Brain-dll/MIDDLE-ALTITUDE-GROUND-STATION-EMBEDDED-/HARDWARE/REV4.0/Mergen Ground Station_V2.0.brd

## EAGLE design HARDWARE/REV4.0/Mergen Ground Station_V2.0.brd (2021-09-17)

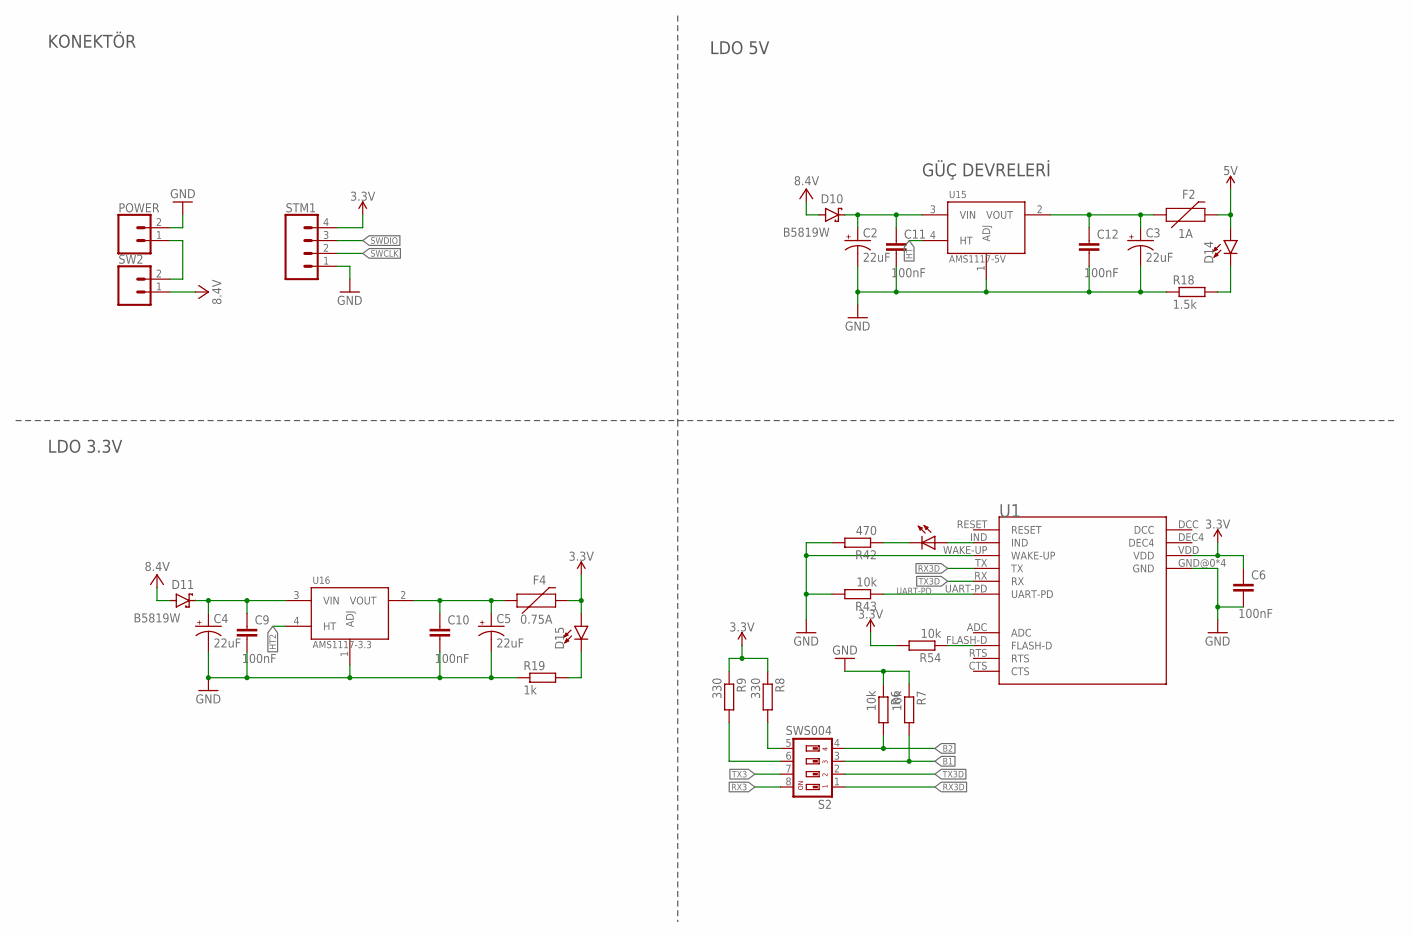
[picture p1: schematic Mergen Ground Station_V2.0.sch, sheet 1]

Parts:
C2, C3, C4, C5: 22uF; CT3528
C6, C9, C10, C11, C12: 100nF; C0603
D10, D11: B5819W; SODFL3718X115
D14, D15: LED0603; LED-0603
DRM3: kirmizi; CHIP-LED0805
F2: 1A; 1206
F4: 0.75A; 1206
POWER: CONN_023.5MM-NO_SILK; SCREWTERMINAL-3.5MM-2-NS
R6, R7, R43, R54: 10k; R0603
R8, R9: 330; R0603
R18: 1.5k; R0603
R19: 1k; R0603
R42: 470; R0603
S2: SWS004; SMS-004
STM1: CONN_04; 1X04
SW2: CONN_023.5MM-NO_SILK; SCREWTERMINAL-3.5MM-2-NS
U1: MDBT42T-AT
U15: AMS1117-5V; SOT229P700X180-4N
U16: AMS1117-3.3; SOT229P700X180-4N

Connections:
3.3V: C6.1, D15.A, F4.2, R8.1, R9.1, R54.2, STM1.4, U1.VDD; also elsewhere on the board
5V: D14.A, F2.2; also elsewhere on the board
B1: R7.2, S2.3; also elsewhere on the board
B2: R6.2, S2.4; also elsewhere on the board
FLASH-D: R54.1, U1.FLASH-D; also elsewhere on the board
GND: C2.-, C3.-, C4.-, C5.-, C6.2, C9.2, C10.2, C11.2, C12.2, POWER.2, R6.1, R7.1, R18.1, R19.1, R42.2, R43.2, STM1.1, U1.GND@0 (GND), U1.GND@1 (GND), U1.GND@2 (GND), U1.GND@3 (GND), U1.WAKE-UP, U15.1 (ADJ), U16.1 (ADJ); also elsewhere on the board
HT: U15.4 (HT)
HT2: U16.4 (HT)
unnamed: DRM3.A, U1.IND
unnamed: DRM3.C, R42.1
unnamed: R9.2, S2.6
unnamed: R8.2, S2.5
unnamed: C2.+, C11.1, D10.1 (C), U15.3 (VIN)
unnamed: C3.+, C12.1, F2.1, U15.2 (VOUT)
unnamed: C4.+, C9.1, D11.1 (C), U16.3 (VIN)
unnamed: C5.+, C10.1, F4.1, U16.2 (VOUT)
unnamed: POWER.1, SW2.2
unnamed: D14.C, R18.2
unnamed: D15.C, R19.2
RX3: S2.8; also elsewhere on the board
RX3D: S2.1, U1.TX
SWCLK: STM1.2; also elsewhere on the board
SWDIO: STM1.3; also elsewhere on the board
TX3: S2.7; also elsewhere on the board
TX3D: S2.2, U1.RX
UART-PD: R43.1, U1.UART-PD; also elsewhere on the board
VCC: D10.2 (A), D11.2 (A), SW2.1; also elsewhere on the board

Notes on the sheet:
GÜÇ DEVRELERİ
KONEKTÖR
LDO 5V
LDO 3.3V

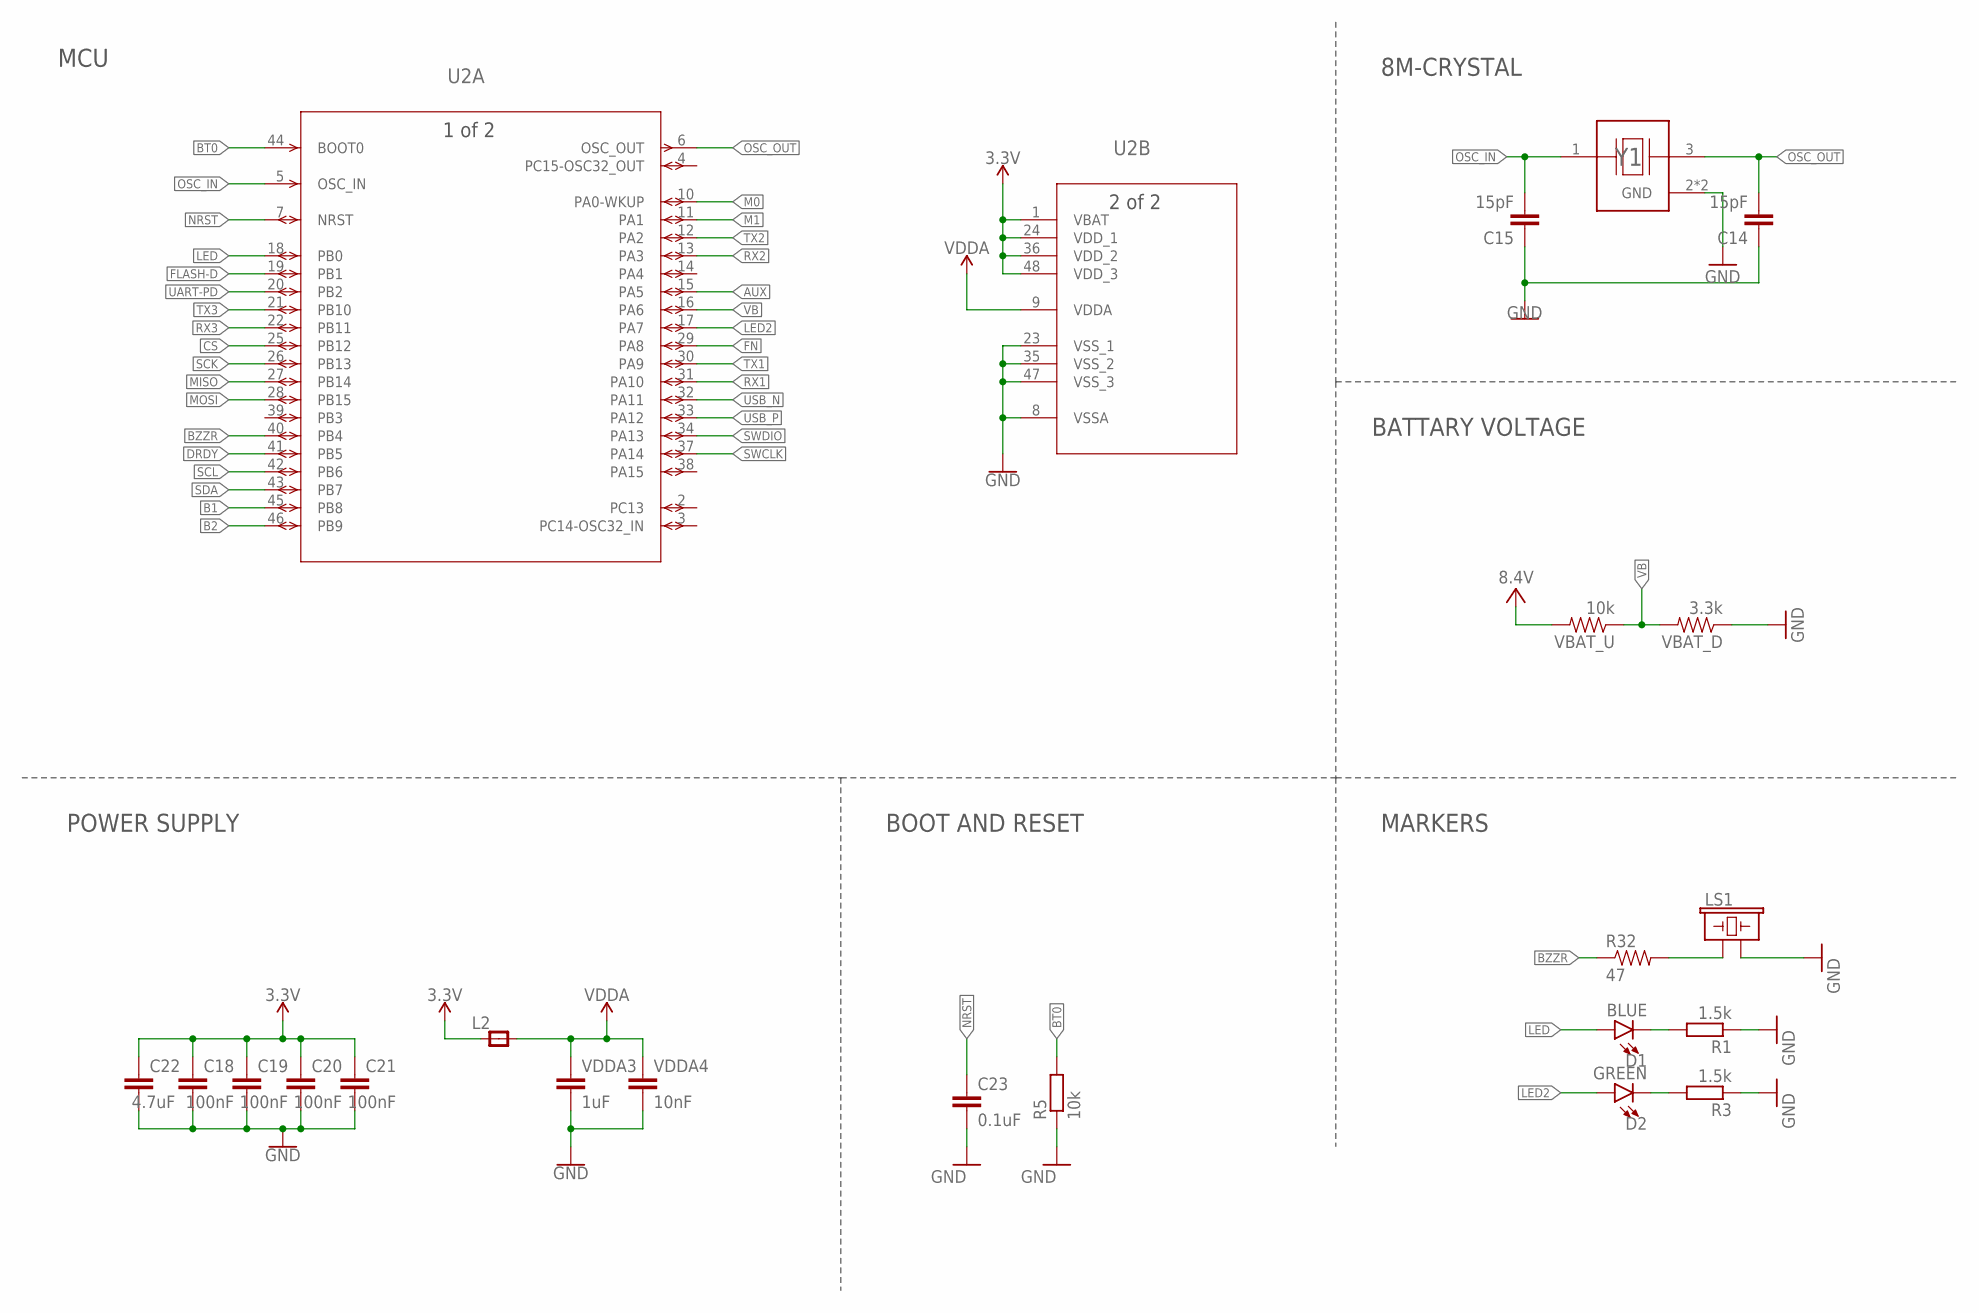
[picture p2: schematic Mergen Ground Station_V2.0.sch, sheet 2]

Parts:
C14, C15: 15pF; C0603
C18, C19, C20, C21: 100nF; C0603
C22: 4.7uF; C0603
C23: 0.1uF; C0603
D1: BLUE; LED-0603
D2: GREEN; LED-0603
L2: RC-MASTER-SMD_FB_0805MP; RC-MASTER-SMD_L0805MP
LS1: BUZZER-PTH; BUZZER-12MM
R1, R3: 1.5k; R0603
R5: 10k; R0603
R32: 47; 0603
U2: STM32F103C8T6; LQFP48-7X7MM
VBAT_D: 3.3k; 0603-RES
VBAT_U: 10k; 0603-RES
VDDA3: 1uF; 0603
VDDA4: 10nF; 0603
Y1: ABMM2-8.000MHZ-E2-T; XTAL_ABMM2-8.000MHZ-E2-T

Connections:
3.3V: C18.1, C19.1, C20.1, C21.1, C22.1, L2.1, U2.1 (VBAT), U2.24 (VDD_1), U2.36 (VDD_2), U2.48 (VDD_3); also elsewhere on the board
AUX: U2.15 (PA5); also elsewhere on the board
B1: U2.45 (PB8); also elsewhere on the board
B2: U2.46 (PB9); also elsewhere on the board
BT0: R5.2, U2.44 (BOOT0)
BZZR: R32.1, U2.40 (PB4)
CS: U2.25 (PB12); also elsewhere on the board
DRDY: U2.41 (PB5); also elsewhere on the board
FLASH-D: U2.19 (PB1); also elsewhere on the board
FN: U2.29 (PA8); also elsewhere on the board
GND: C14.1, C15.1, C18.2, C19.2, C20.2, C21.2, C22.2, C23.2, LS1.- (2), R1.1, R3.1, R5.1, U2.8 (VSSA), U2.23 (VSS_1), U2.35 (VSS_2), U2.47 (VSS_3), VBAT_D.1, VDDA3.2, VDDA4.2, Y1.2 (GND), Y1.4 (GND); also elsewhere on the board
LED: D1.A, U2.18 (PB0)
LED2: D2.A, U2.17 (PA7)
M0: U2.10 (PA0-WKUP); also elsewhere on the board
M1: U2.11 (PA1); also elsewhere on the board
MISO: U2.27 (PB14); also elsewhere on the board
MOSI: U2.28 (PB15); also elsewhere on the board
unnamed: D1.C, R1.2
unnamed: D2.C, R3.2
unnamed: LS1.+ (1), R32.2
NRST: C23.1, U2.7 (NRST)
OSC_IN: C15.2, U2.5 (OSC_IN), Y1.1
OSC_OUT: C14.2, U2.6 (OSC_OUT), Y1.3
RX1: U2.31 (PA10); also elsewhere on the board
RX2: U2.13 (PA3); also elsewhere on the board
RX3: U2.22 (PB11); also elsewhere on the board
SCK: U2.26 (PB13); also elsewhere on the board
SCL: U2.42 (PB6); also elsewhere on the board
SDA: U2.43 (PB7); also elsewhere on the board
SWCLK: U2.37 (PA14); also elsewhere on the board
SWDIO: U2.34 (PA13); also elsewhere on the board
TX1: U2.30 (PA9); also elsewhere on the board
TX2: U2.12 (PA2); also elsewhere on the board
TX3: U2.21 (PB10); also elsewhere on the board
UART-PD: U2.20 (PB2); also elsewhere on the board
USB_N: U2.32 (PA11); also elsewhere on the board
USB_P: U2.33 (PA12); also elsewhere on the board
VB: U2.16 (PA6), VBAT_D.2, VBAT_U.1
VCC: VBAT_U.2; also elsewhere on the board
VDDA: L2.2, U2.9 (VDDA), VDDA3.1, VDDA4.1

Notes on the sheet:
MCU
8M-CRYSTAL
BATTARY VOLTAGE
MARKERS
BOOT AND RESET
POWER SUPPLY

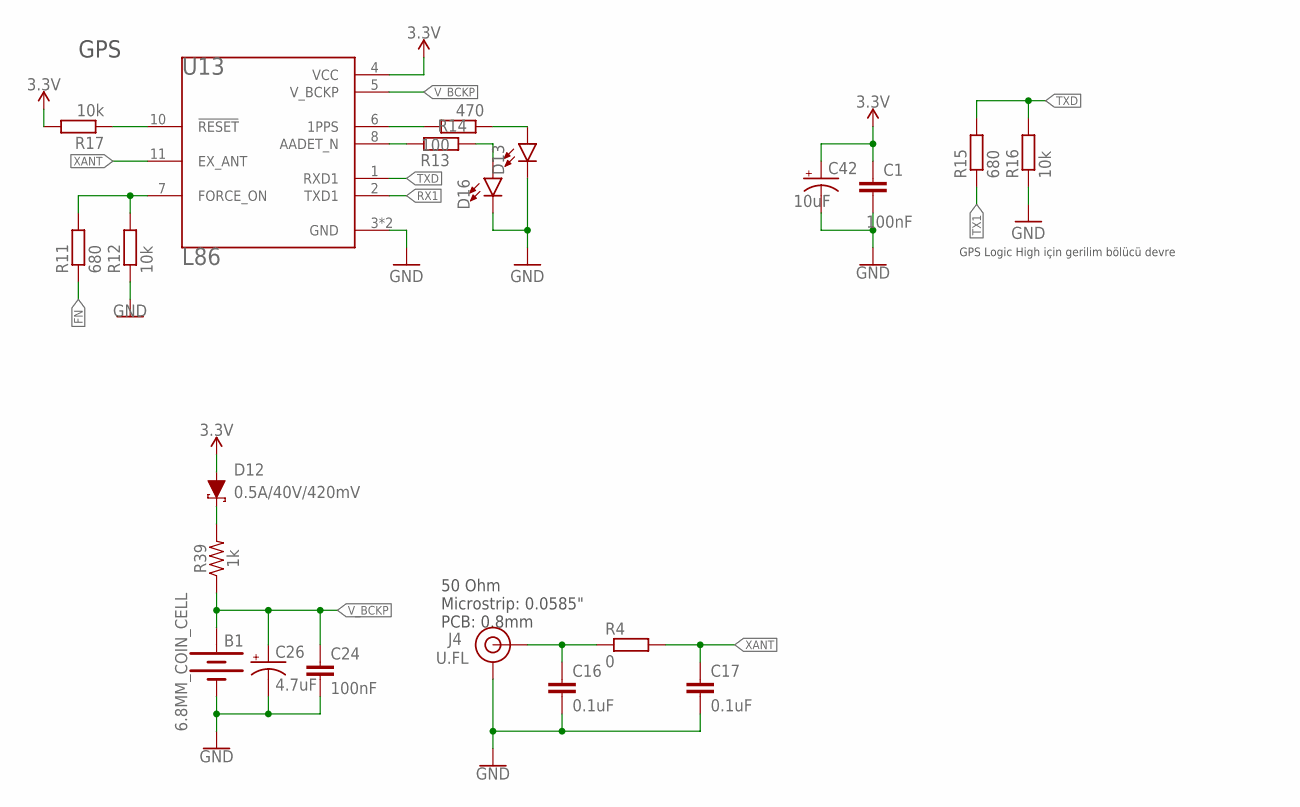
[picture p3: schematic Mergen Ground Station_V2.0.sch, sheet 3]

Parts:
B1: 6.8MM_COIN_CELL; BATTCON-6.8MM
C1, C24: 100nF; C0603
C16, C17: 0.1uF; C0603
C26: 4.7uF; A/3216-18R
C42: 10uF; EIA3216
D12: 0.5A/40V/420mV; SOD-323
D13, D16: LED0603; LED-0603
J4: U.FL
R4: 0; R0603
R11, R15: 680; R0603
R12, R16, R17: 10k; R0603
R13: 100; R0603
R14: 470; R0603
R39: 1k; 0603
U13: L86; XCVR_L86

Connections:
3.3V: C1.1, C42.+, D12.A, R17.2, U13.4 (VCC); also elsewhere on the board
FN: R11.1; also elsewhere on the board
GND: B1.-, C1.2, C16.2, C17.2, C24.2, C26.-, C42.-, D13.C, D16.C, J4.1 (GND), J4.2 (GND), R12.1, R16.1, U13.3 (GND), U13.12 (GND); also elsewhere on the board
unnamed: D16.A, R13.1
unnamed: D12.C, R39.2
unnamed: R17.1, U13.10 (!RESET)
unnamed: R14.2, U13.6 (1PPS)
unnamed: D13.A, R14.1
unnamed: R13.2, U13.8 (AADET_N)
unnamed: C16.1, J4.FEED (SIGNAL), R4.1
unnamed: R11.2, R12.2, U13.7 (FORCE_ON)
RX1: U13.2 (TXD1); also elsewhere on the board
TX1: R15.1; also elsewhere on the board
TXD: R15.2, R16.2, U13.1 (RXD1)
V_BCKP: B1.+, C24.1, C26.+, R39.1, U13.5 (V_BCKP)
XANT: C17.1, R4.2, U13.11 (EX_ANT)

Notes on the sheet:
GPS
GPS Logic High için gerilim bölücü devre
50 Ohm Microstrip: 0.0585" PCB: 0.8mm

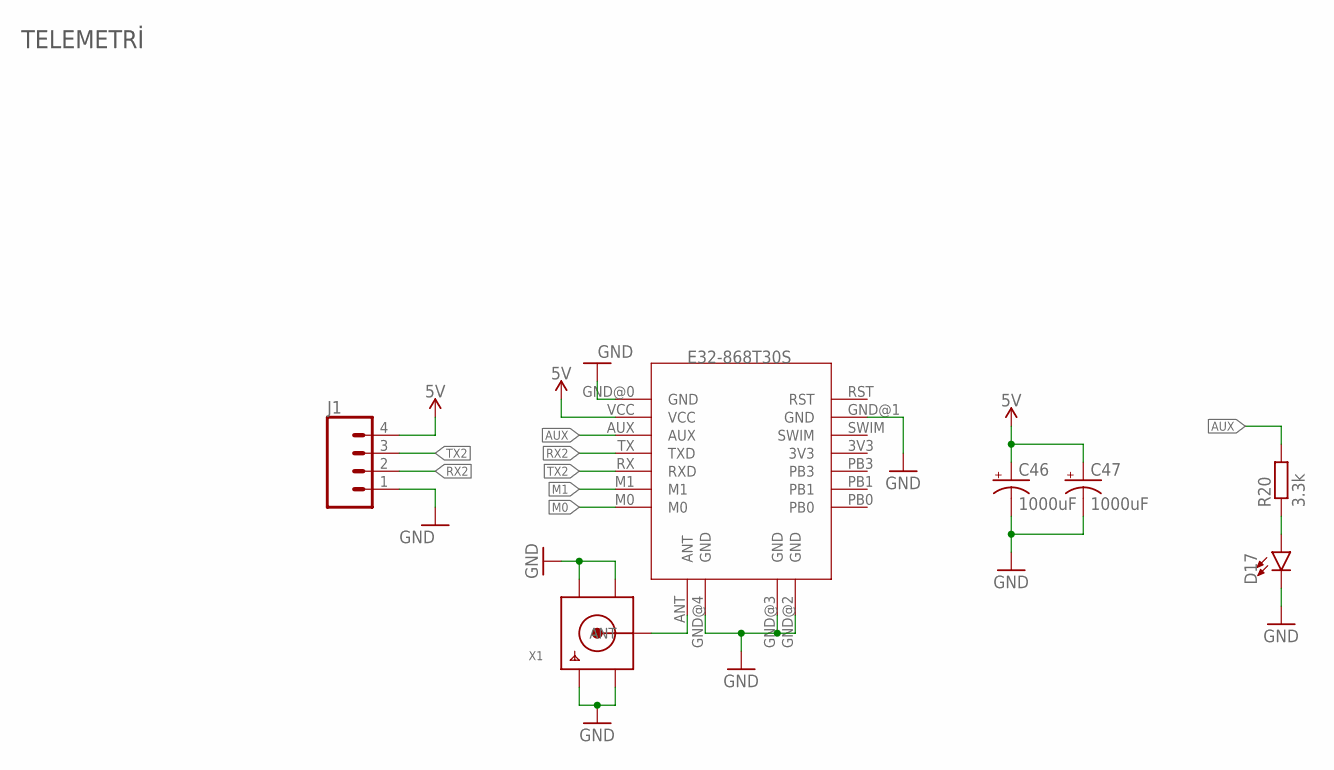
[picture p4: schematic Mergen Ground Station_V2.0.sch, sheet 4]

Parts:
C46, C47: 1000uF; 150CLZ-1010
D17: LED0603; LED-0603
J1: CONN_04; 1X04
R20: 3.3k; R0603
U14: E32-868T30S
X1: SMACONNECTOR; SMA90_DIP

Connections:
5V: C46.+, C47.+, J1.4, U14.VCC; also elsewhere on the board
AUX: R20.2, U14.AUX; also elsewhere on the board
GND: C46.-, C47.-, D17.C, J1.1, U14.GND@0 (GND), U14.GND@1 (GND), U14.GND@2 (GND), U14.GND@3 (GND), U14.GND@4 (GND), X1.GND1, X1.GND2, X1.GND3, X1.GND4; also elsewhere on the board
M0: U14.M0; also elsewhere on the board
M1: U14.M1; also elsewhere on the board
unnamed: U14.ANT, X1.ANTENNA (ANT)
unnamed: D17.A, R20.1
RX2: J1.2, U14.TX (TXD); also elsewhere on the board
TX2: J1.3, U14.RX (RXD); also elsewhere on the board

Notes on the sheet:
TELEMETRİ

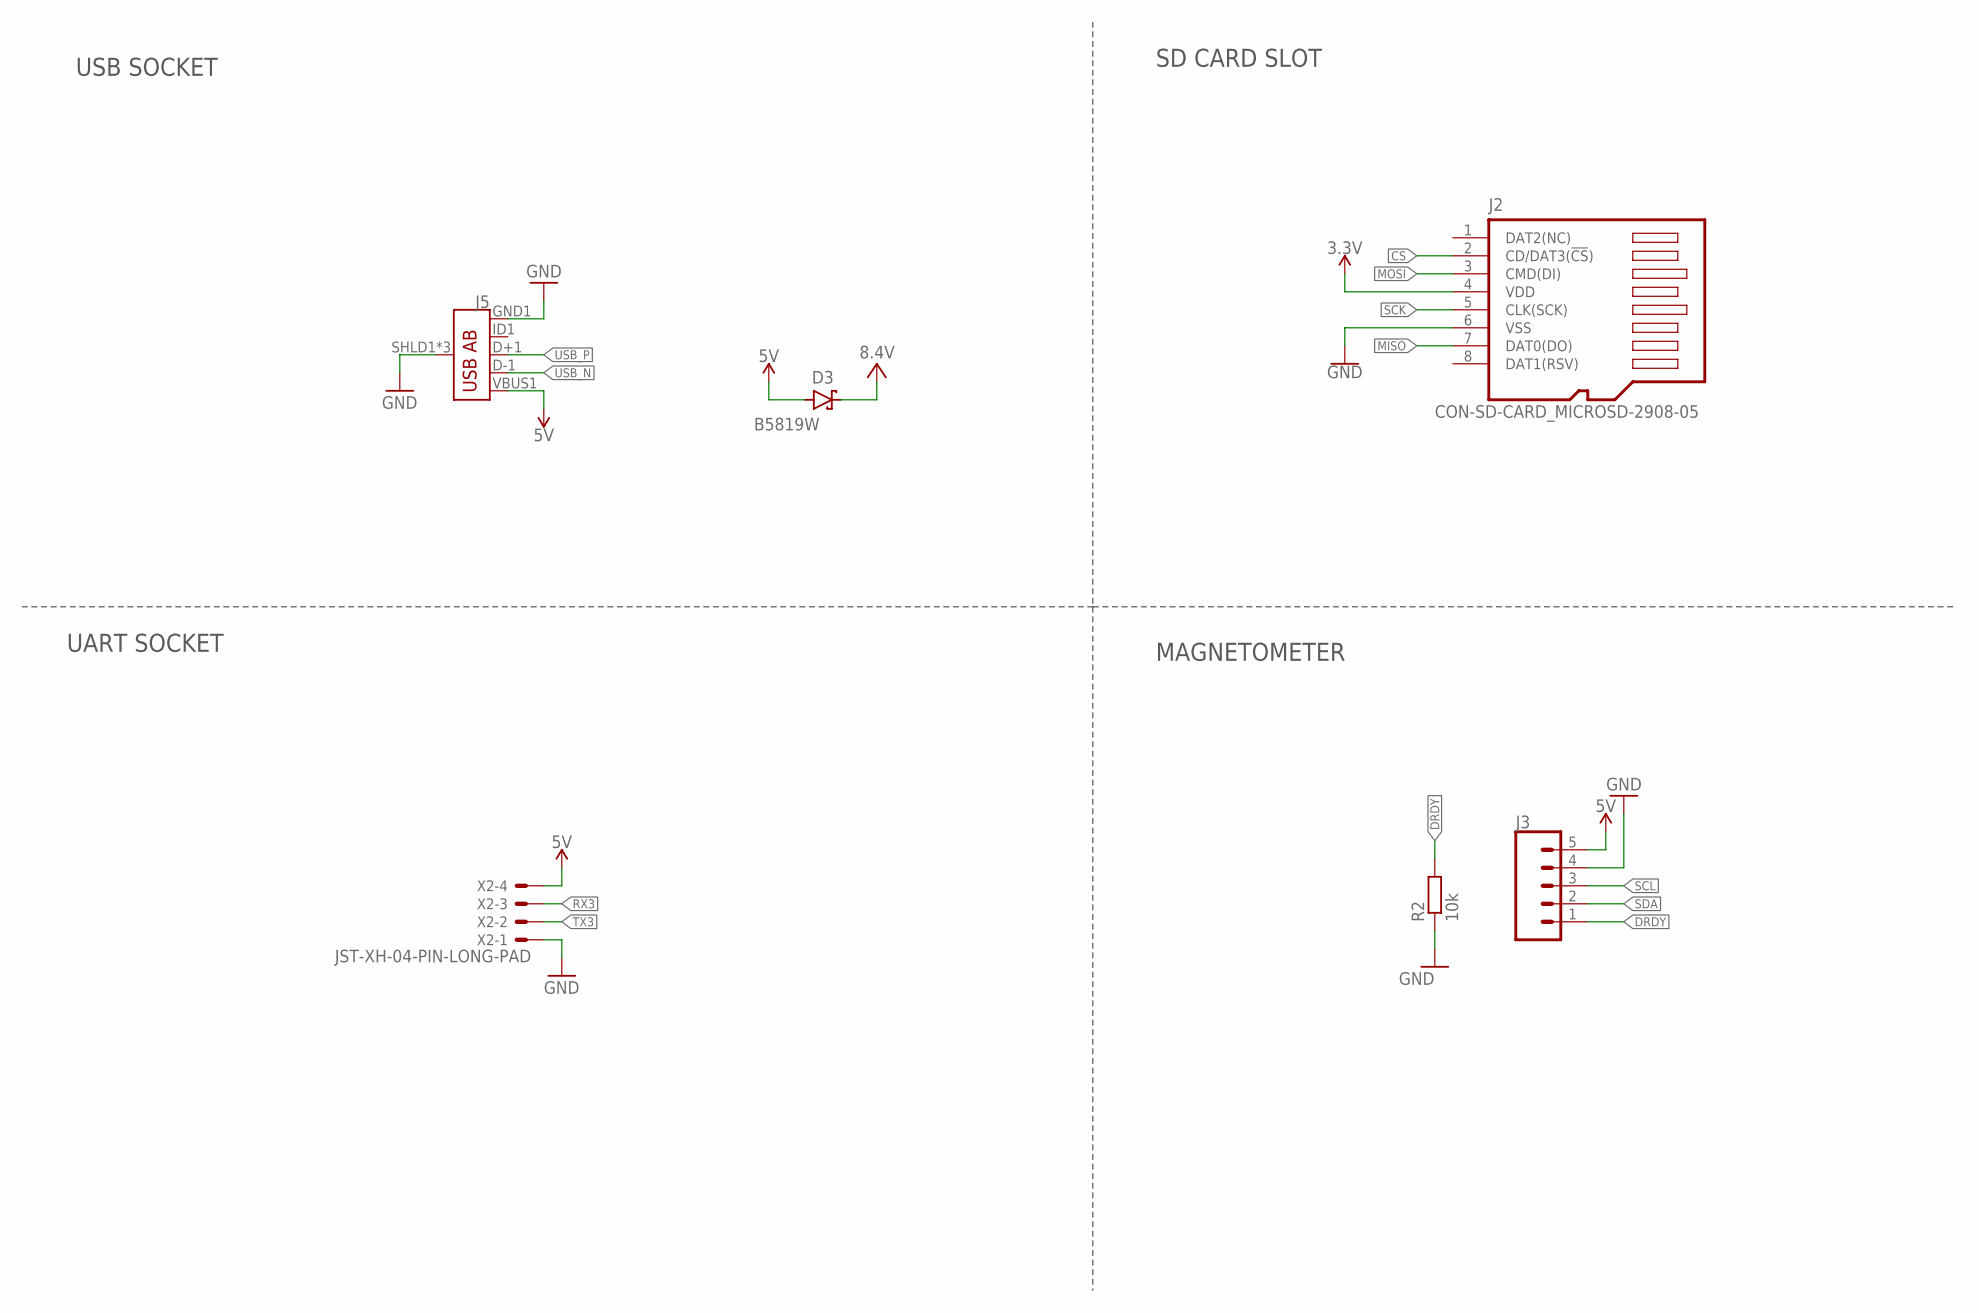
[picture p5: schematic Mergen Ground Station_V2.0.sch, sheet 5]

Parts:
D3: B5819W; SODFL3718X115
J2: CON-SD-CARD_MICROSD-2908-05; CON-SD-CARD_2908-05
J3: CONN_05LOCK_LONGPADS; 1X05_LOCK_LONGPADS
J5: USB_AB_SMT; USB-AB-MICRO-SMD
R2: 10k; R0603
X2: JST-XH-04-PIN-LONG-PAD; JST-XH-04-PACKAGE-LONG-PAD

Connections:
3.3V: J2.4 (VDD); also elsewhere on the board
5V: D3.2 (A), J3.5, J5.VBUS1 (VBUS), X2.4; also elsewhere on the board
CS: J2.2 (CD/DAT3(!CS!)); also elsewhere on the board
DRDY: J3.1, R2.2; also elsewhere on the board
GND: J2.6 (VSS), J3.4, J5.GND1 (GND), J5.SHLD1 (SHIELD), J5.SHLD2 (SHIELD), J5.SHLD3 (SHIELD), R2.1, X2.1; also elsewhere on the board
MISO: J2.7 (DAT0(DO)); also elsewhere on the board
MOSI: J2.3 (CMD(DI)); also elsewhere on the board
RX3: X2.3; also elsewhere on the board
SCK: J2.5 (CLK(SCK)); also elsewhere on the board
SCL: J3.3; also elsewhere on the board
SDA: J3.2; also elsewhere on the board
TX3: X2.2; also elsewhere on the board
USB_N: J5.D-1 (D-); also elsewhere on the board
USB_P: J5.D+1 (D+); also elsewhere on the board
VCC: D3.1 (C); also elsewhere on the board

Notes on the sheet:
USB SOCKET
SD CARD SLOT
UART SOCKET
MAGNETOMETER

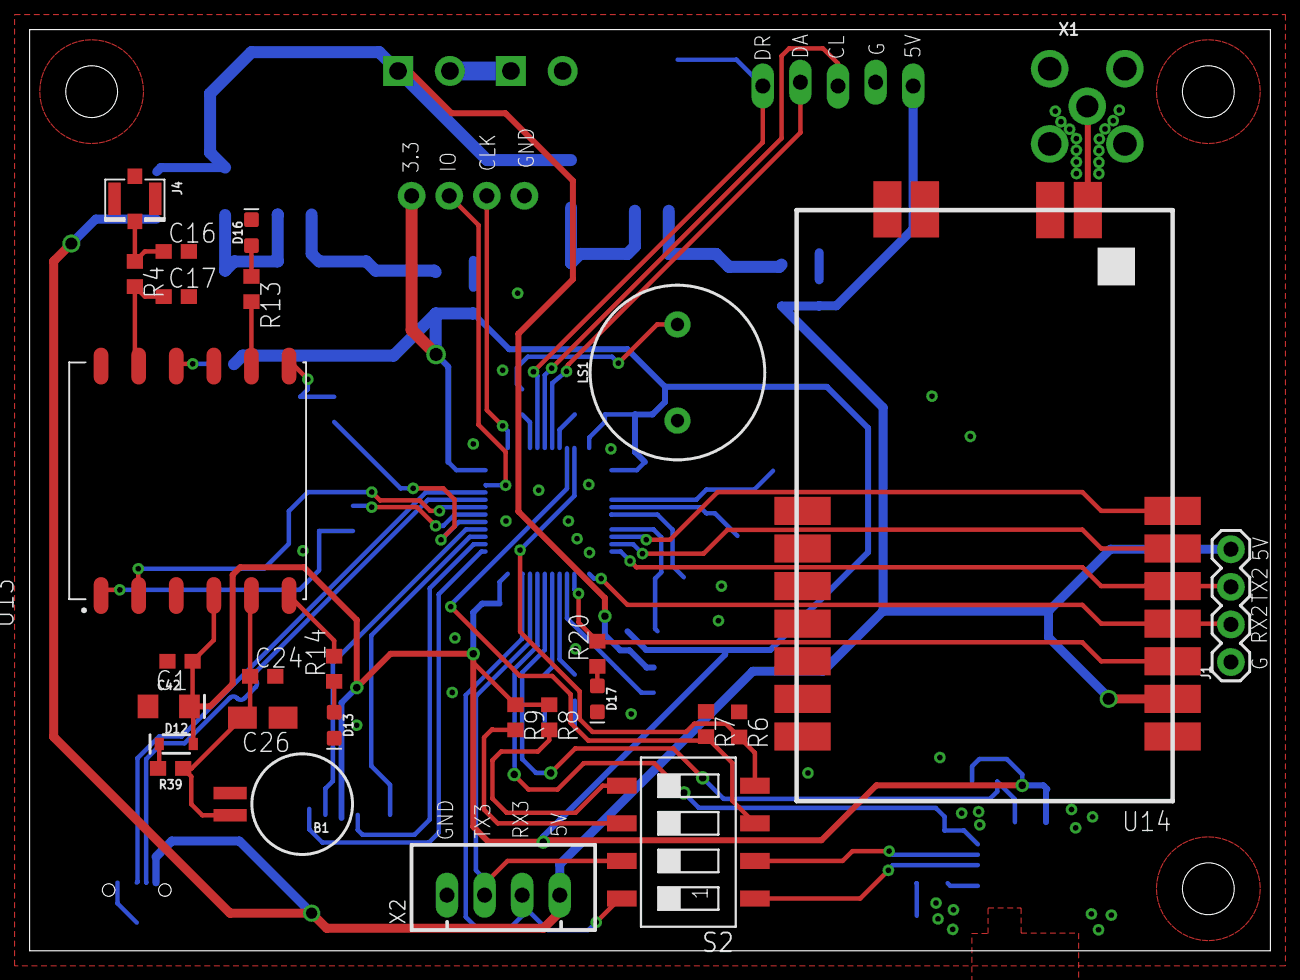
[picture p6: board HARDWARE/REV4.0/Mergen Ground Station_V2.0.brd from above]

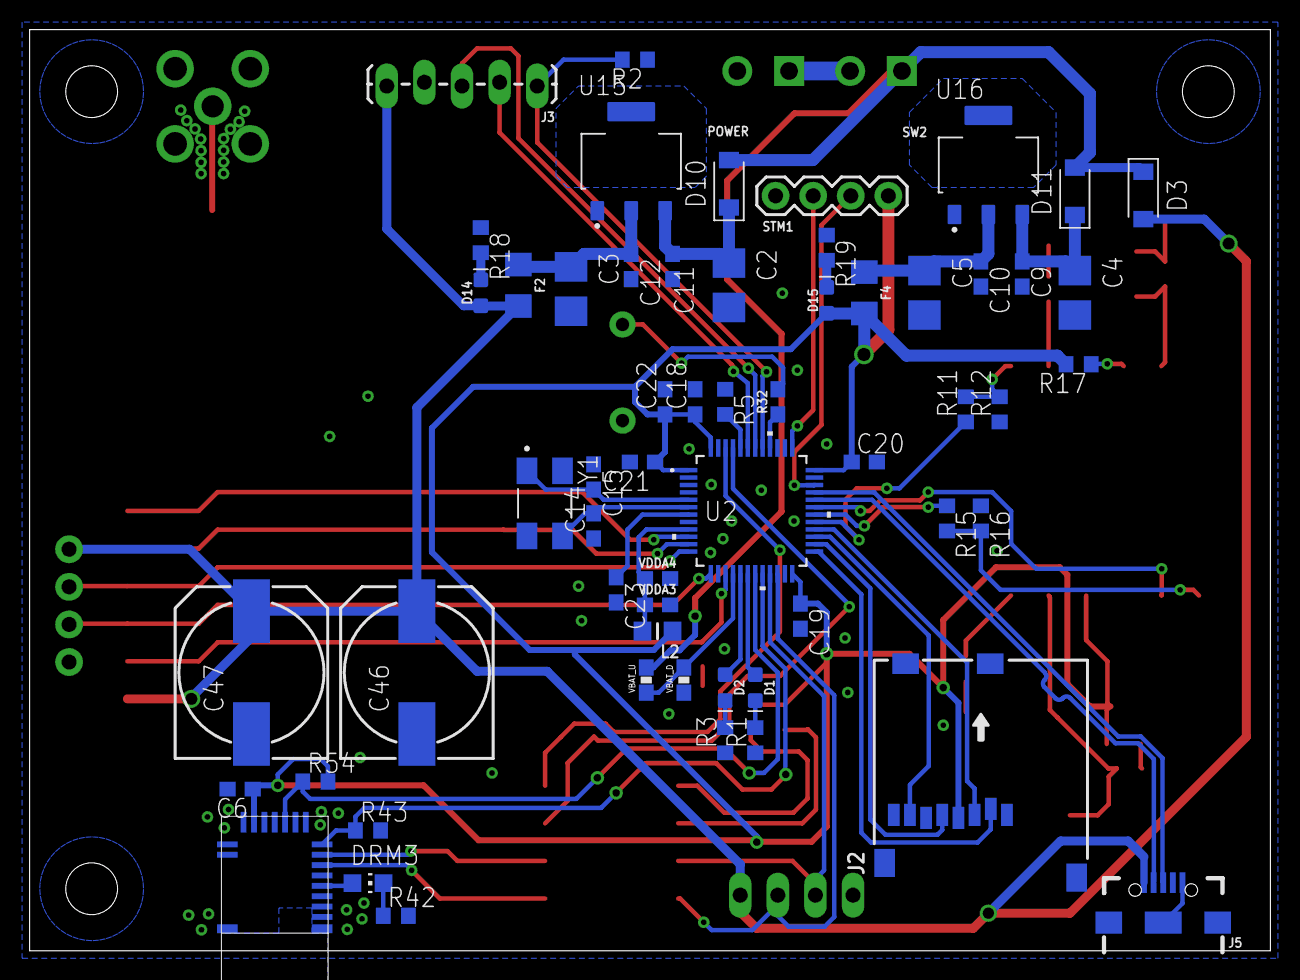
[picture p7: board HARDWARE/REV4.0/Mergen Ground Station_V2.0.brd from below]

Board: 2 copper layers, 83.8 x 62.2 mm, 88 parts (60 on the bottom side), 67 nets.
