Brain-dll/MIDDLE-ALTITUDE-GROUND-STATION-EMBEDDED-/HARDWARE-DESIGN/OSMAN - REV2.0/Mergen Ground Station_V2.0.brd

## EAGLE design HARDWARE-DESIGN/OSMAN - REV2.0/Mergen Ground Station_V2.0.brd (2021-06-02, an earlier design)

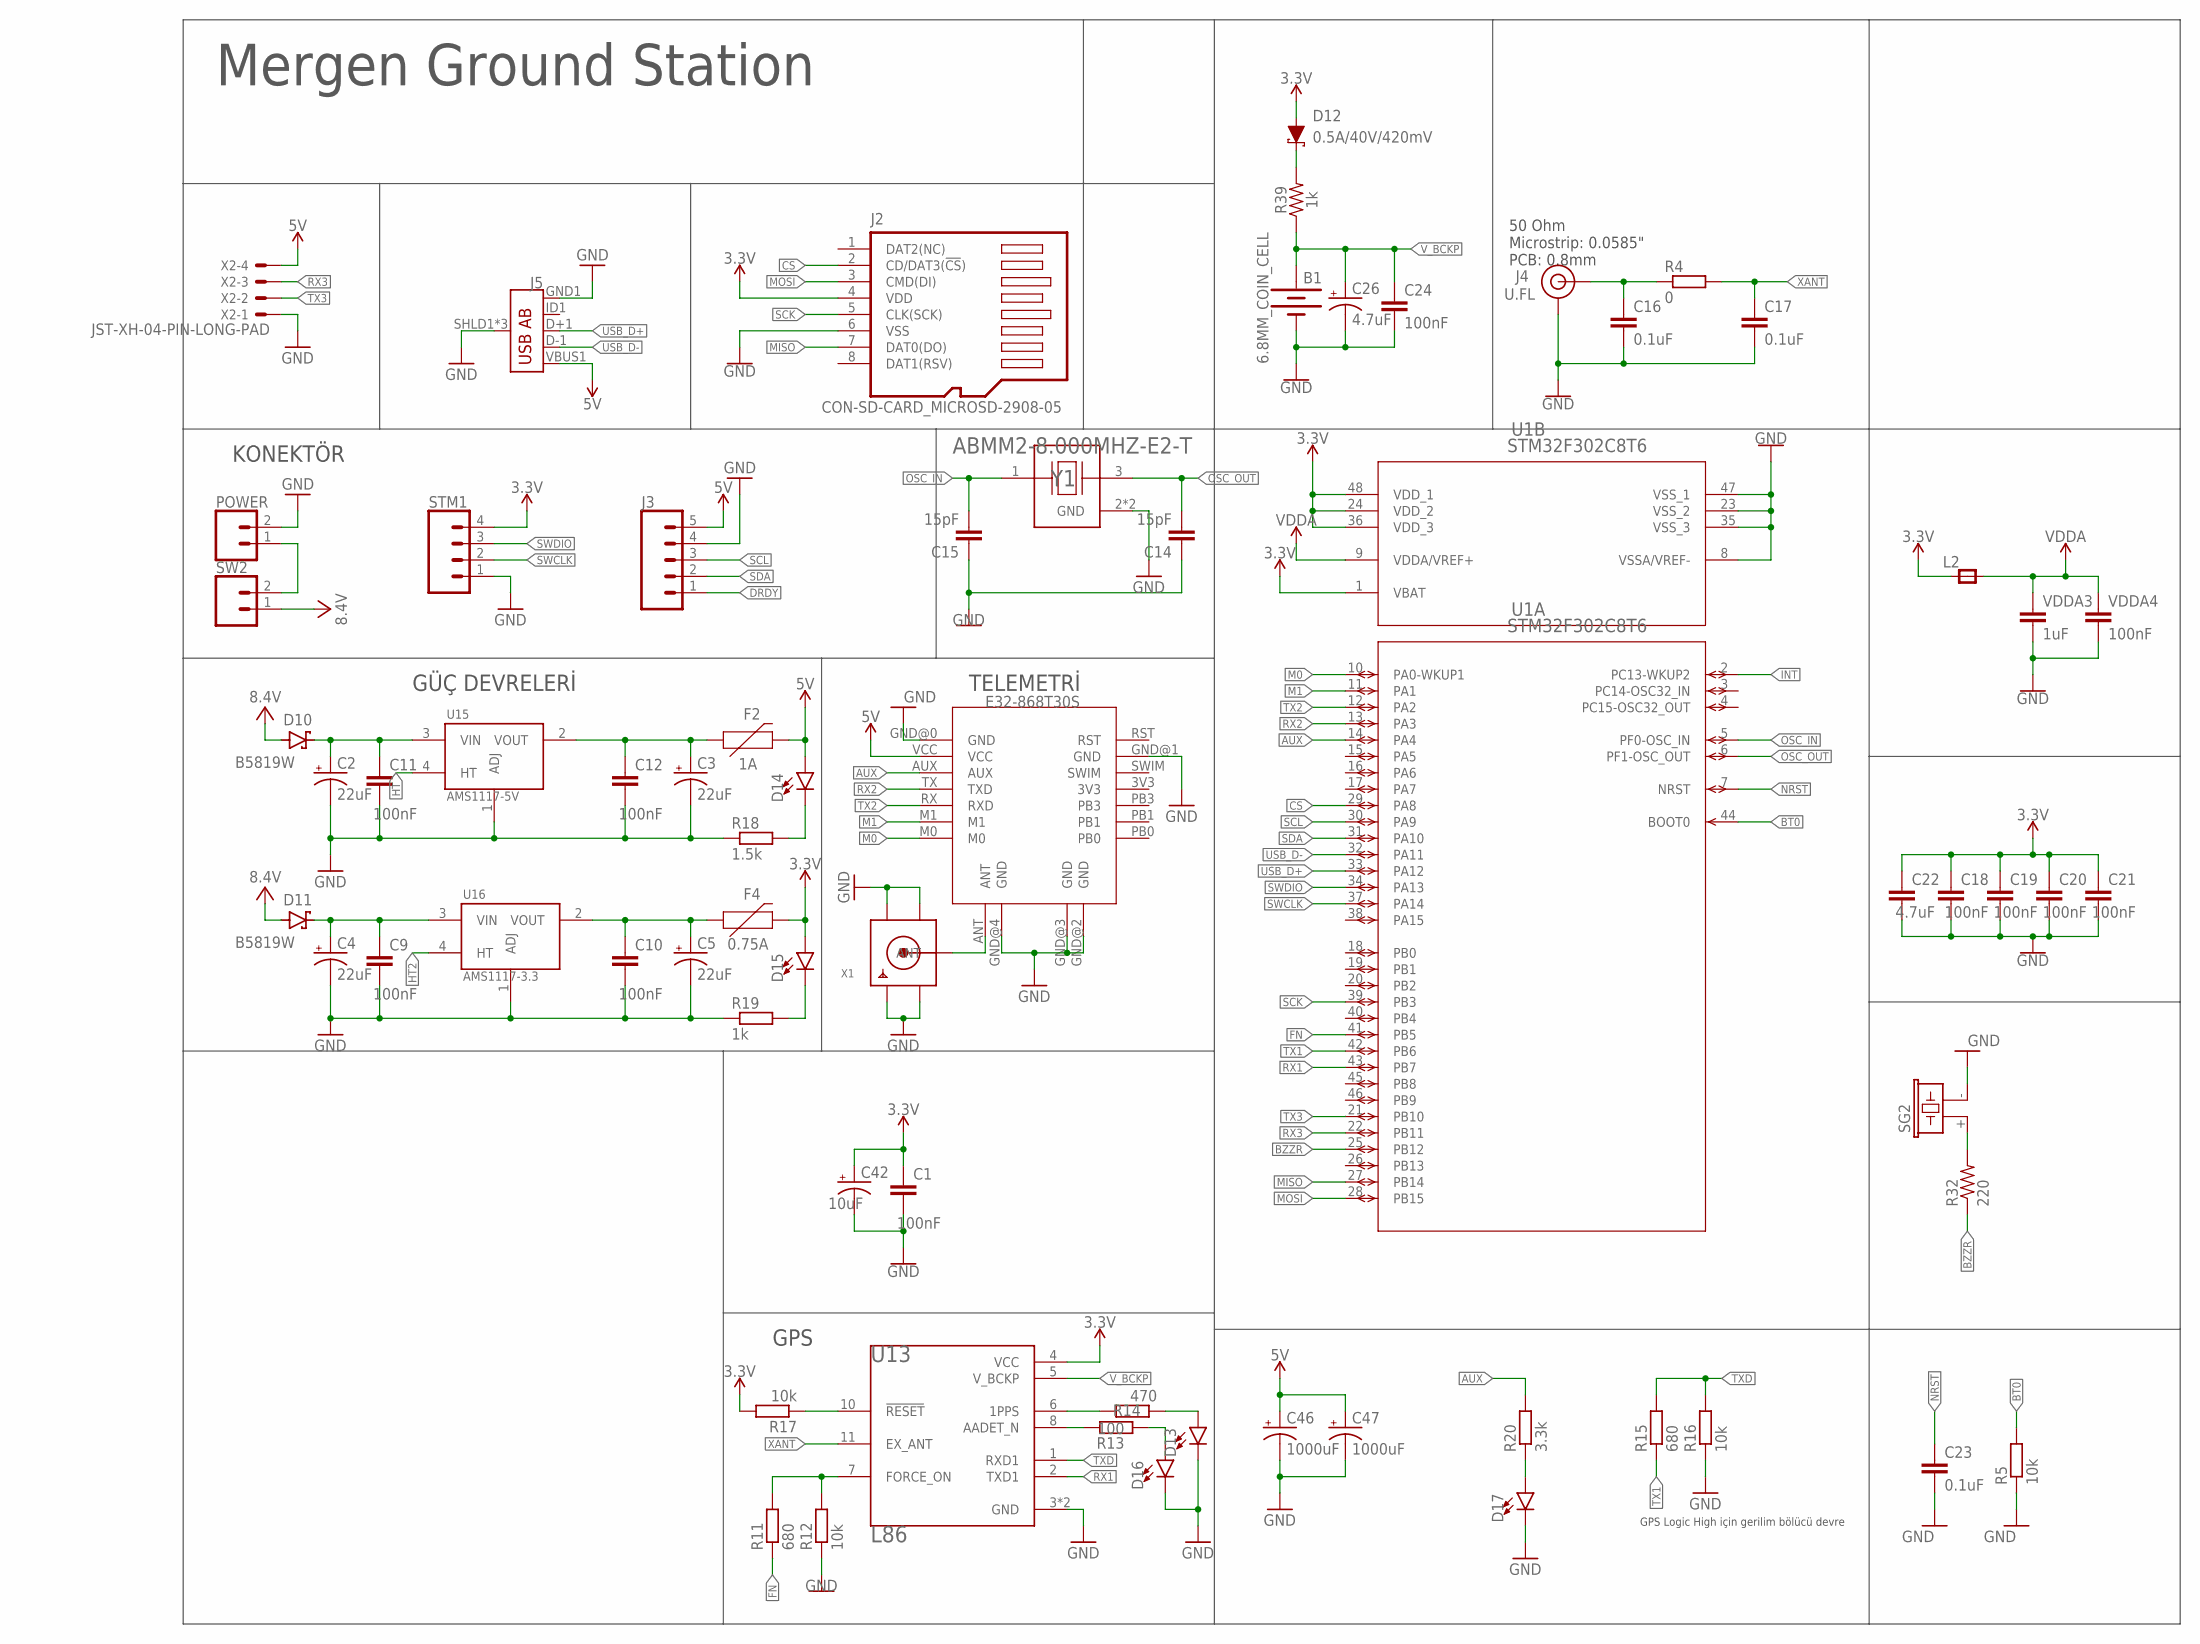
[picture p8: schematic Mergen Ground Station_V2.0.sch]

Parts:
B1: 6.8MM_COIN_CELL; BATTCON-6.8MM
C1, C9, C10, C11, C12, C18, C19, C20, C21, C24: 100nF; C0603
C2, C3, C4, C5: 22uF; CT3528
C14, C15: 15pF; C0603
C16, C17, C23: 0.1uF; C0603
C22: 4.7uF; C0603
C26: 4.7uF; A/3216-18R
C42: 10uF; EIA3216
C46, C47: 1000uF; 150CLZ-1010
D10, D11: B5819W; SODFL3718X115
D12: 0.5A/40V/420mV; SOD-323
D13, D14, D15, D16, D17: LED0603; LED-0603
F2: 1A; 1206
F4: 0.75A; 1206
J2: CON-SD-CARD_MICROSD-2908-05; CON-SD-CARD_2908-05
J3: CONN_05LOCK_LONGPADS; 1X05_LOCK_LONGPADS
J4: U.FL
J5: USB_AB_SMT; USB-AB-MICRO-SMD
L2: RC-MASTER-SMD_FB_0805MP; RC-MASTER-SMD_L0805MP
POWER: CONN_023.5MM-NO_SILK; SCREWTERMINAL-3.5MM-2-NS
R4: 0; R0603
R5, R12, R16, R17: 10k; R0603
R11, R15: 680; R0603
R13: 100; R0603
R14: 470; R0603
R18: 1.5k; R0603
R19: 1k; R0603
R20: 3.3k; R0603
R32: 220; 0603
R39: 1k; 0603
SG2: F/CM12P
STM1: CONN_04; 1X04
SW2: CONN_023.5MM-NO_SILK; SCREWTERMINAL-3.5MM-2-NS
U1: STM32F302C8T6; LQFP48-7X7MM
U13: L86; XCVR_L86
U14: E32-868T30S
U15: AMS1117-5V; SOT229P700X180-4N
U16: AMS1117-3.3; SOT229P700X180-4N
VDDA3: 1uF; 0603
VDDA4: 100nF; 0603
X1: SMACONNECTOR; SMA90_DIP
X2: JST-XH-04-PIN-LONG-PAD; JST-XH-04-PACKAGE-LONG-PAD
Y1: ABMM2-8.000MHZ-E2-T; XTAL_ABMM2-8.000MHZ-E2-T

Connections:
3.3V: C1.1, C18.1, C19.1, C20.1, C21.1, C22.1, C42.+, D12.A, D15.A, F4.2, J2.4 (VDD), L2.1, R17.2, STM1.4, U1.1 (VBAT), U1.24 (VDD_2), U1.36 (VDD_3), U1.48 (VDD_1), U13.4 (VCC)
5V: C46.+, C47.+, D14.A, F2.2, J3.5, J5.VBUS1 (VBUS), U14.VCC, X2.4
AUX: R20.2, U1.14 (PA4), U14.AUX
BT0: R5.2, U1.44 (BOOT0)
BZZR: R32.1, U1.25 (PB12)
CS: J2.2 (CD/DAT3(!CS!)), U1.29 (PA8)
DRDY: J3.1
FN: R11.1, U1.41 (PB5)
GND: B1.-, C1.2, C2.-, C3.-, C4.-, C5.-, C9.2, C10.2, C11.2, C12.2, C14.1, C15.1, C16.2, C17.2, C18.2, C19.2, C20.2, C21.2, C22.2, C23.2, C24.2, C26.-, C42.-, C46.-, C47.-, D13.C, D16.C, D17.C, J2.6 (VSS), J3.4, J4.1 (GND), J4.2 (GND), J5.GND1 (GND), J5.SHLD1 (SHIELD), J5.SHLD2 (SHIELD), J5.SHLD3 (SHIELD), POWER.2, R5.1, R12.1, R16.1, R18.1, R19.1, SG2.- (2), STM1.1, U1.8 (VSSA/VREF-), U1.23 (VSS_2), U1.35 (VSS_3), U1.47 (VSS_1), U13.3 (GND), U13.12 (GND), U14.GND@0 (GND), U14.GND@1 (GND), U14.GND@2 (GND), U14.GND@3 (GND), U14.GND@4 (GND), U15.1 (ADJ), U16.1 (ADJ), VDDA3.2, VDDA4.2, X1.GND1, X1.GND2, X1.GND3, X1.GND4, X2.1, Y1.2 (GND), Y1.4 (GND)
HT: U15.4 (HT)
HT2: U16.4 (HT)
INT: U1.2 (PC13-WKUP2)
M0: U1.10 (PA0-WKUP1), U14.M0
M1: U1.11 (PA1), U14.M1
MISO: J2.7 (DAT0(DO)), U1.27 (PB14)
MOSI: J2.3 (CMD(DI)), U1.28 (PB15)
unnamed: D16.A, R13.1
unnamed: C2.+, C11.1, D10.1 (C), U15.3 (VIN)
unnamed: C3.+, C12.1, F2.1, U15.2 (VOUT)
unnamed: C4.+, C9.1, D11.1 (C), U16.3 (VIN)
unnamed: C5.+, C10.1, F4.1, U16.2 (VOUT)
unnamed: U14.ANT, X1.ANTENNA (ANT)
unnamed: R32.2, SG2.+ (1)
unnamed: POWER.1, SW2.2
unnamed: D12.C, R39.2
unnamed: R17.1, U13.10 (!RESET)
unnamed: R14.2, U13.6 (1PPS)
unnamed: D13.A, R14.1
unnamed: D14.C, R18.2
unnamed: D15.C, R19.2
unnamed: R13.2, U13.8 (AADET_N)
unnamed: C16.1, J4.FEED (SIGNAL), R4.1
unnamed: R11.2, R12.2, U13.7 (FORCE_ON)
unnamed: D17.A, R20.1
NRST: C23.1, U1.7 (NRST)
OSC_IN: C15.2, U1.5 (PF0-OSC_IN), Y1.1
OSC_OUT: C14.2, U1.6 (PF1-OSC_OUT), Y1.3
RX1: U1.43 (PB7), U13.2 (TXD1)
RX2: U1.13 (PA3), U14.TX (TXD)
RX3: U1.22 (PB11), X2.3
SCK: J2.5 (CLK(SCK)), U1.39 (PB3)
SCL: J3.3, U1.30 (PA9)
SDA: J3.2, U1.31 (PA10)
SWCLK: STM1.2, U1.37 (PA14)
SWDIO: STM1.3, U1.34 (PA13)
TX1: R15.1, U1.42 (PB6)
TX2: U1.12 (PA2), U14.RX (RXD)
TX3: U1.21 (PB10), X2.2
TXD: R15.2, R16.2, U13.1 (RXD1)
USB_D+: J5.D+1 (D+), U1.33 (PA12)
USB_D-: J5.D-1 (D-), U1.32 (PA11)
VCC: D10.2 (A), D11.2 (A), SW2.1
VDDA: L2.2, U1.9 (VDDA/VREF+), VDDA3.1, VDDA4.1
V_BCKP: B1.+, C24.1, C26.+, R39.1, U13.5 (V_BCKP)
XANT: C17.1, R4.2, U13.11 (EX_ANT)

Notes on the sheet:
Mergen Ground Station
GÜÇ DEVRELERİ
TELEMETRİ
GPS
KONEKTÖR
50 Ohm Microstrip: 0.0585" PCB: 0.8mm
GPS Logic High için gerilim bölücü devre
