Brain-dll/MIDDLE-ALTITUDE-GROUND-STATION-EMBEDDED-/HARDWARE-DESIGN/OSMAN - REV2.0/Mergen Ground Station_V2.0.brd

## EAGLE design HARDWARE-DESIGN/OSMAN - REV2.0/Mergen Ground Station_V2.0.brd (continued)

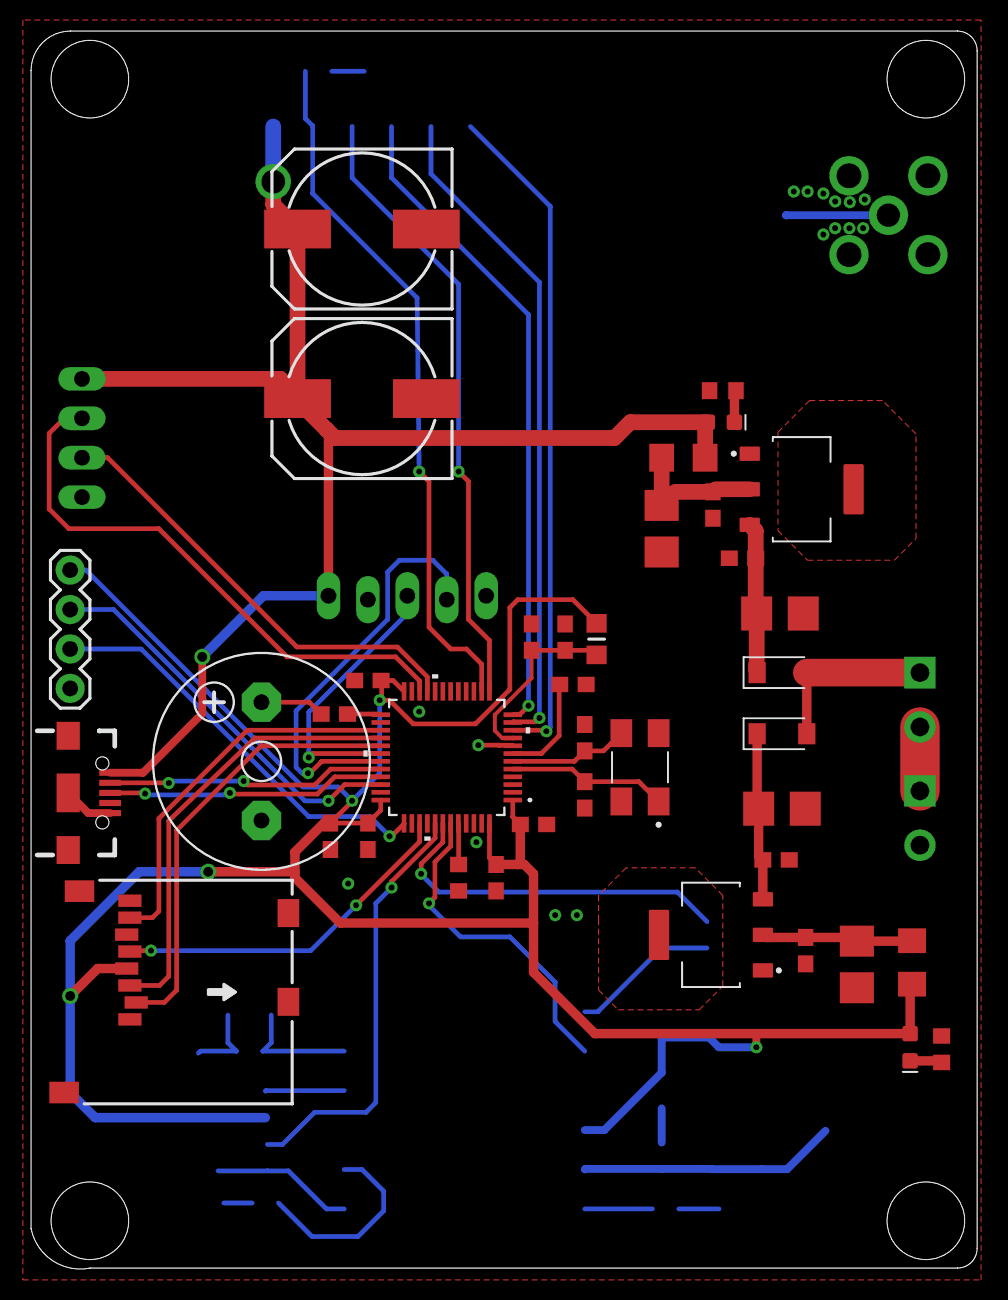
[picture p9: board HARDWARE-DESIGN/OSMAN - REV2.0/Mergen Ground Station_V2.0.brd from above]

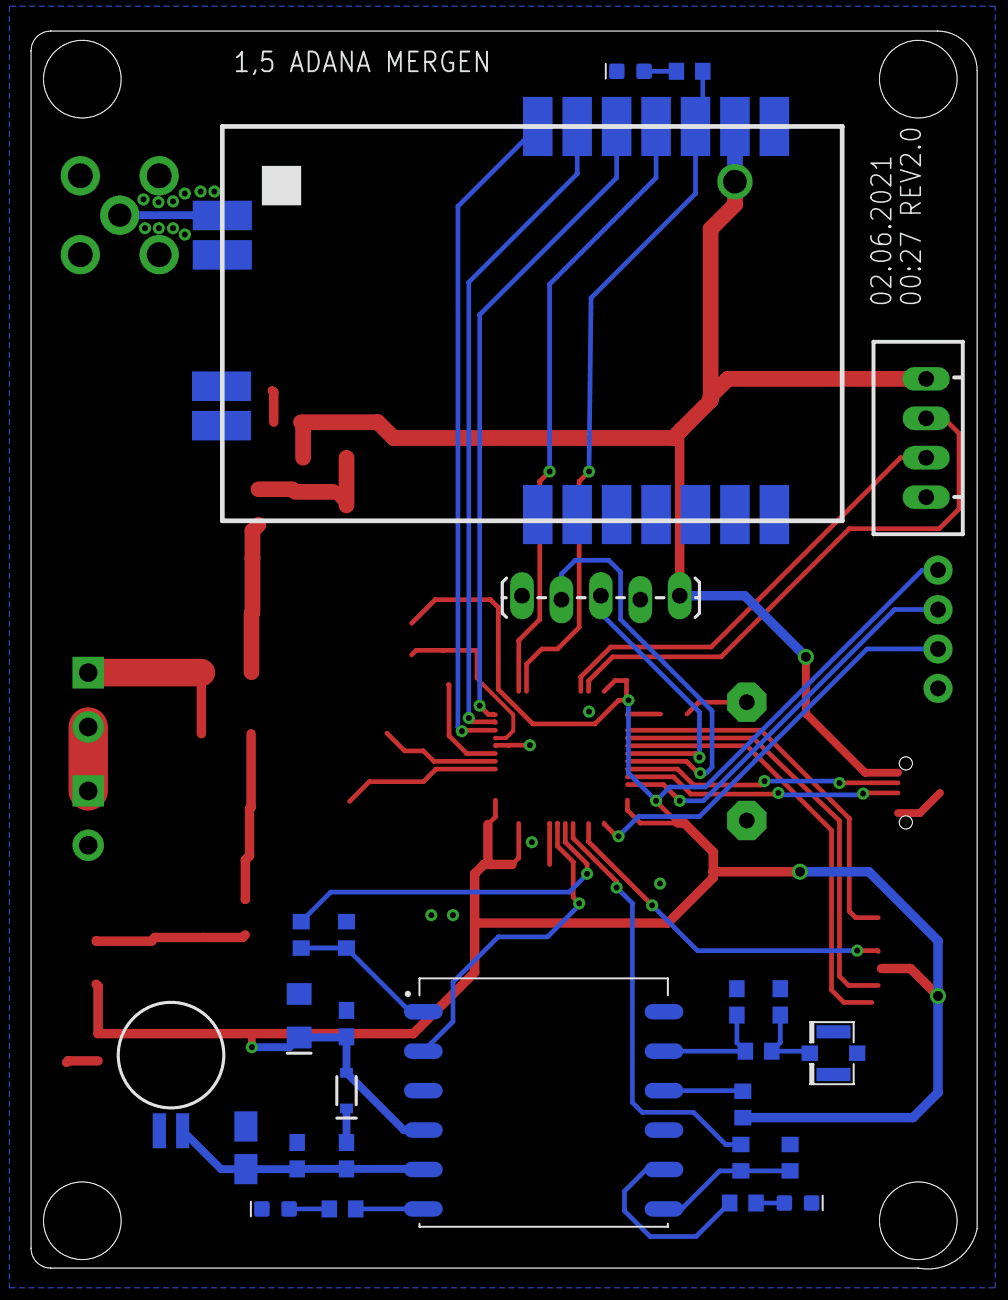
[picture p10: board HARDWARE-DESIGN/OSMAN - REV2.0/Mergen Ground Station_V2.0.brd from below]

Board: 2 copper layers, 60.9 x 79.7 mm, 68 parts (29 on the bottom side), 51 nets.
