Brain-dll/MIDDLE-ALTITUDE-GROUND-STATION-EMBEDDED-/GROUND_STATION_SOFTWARE/Core/Src/main.c

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
/* Includes ------------------------------------------------------------------*/
#include "main.h"

/* USER CODE BEGIN Includes */
#include "MAGNETO.h"
#include "stdio.h"
#include "math.h"
#include "string.h"
#include <stdlib.h>
#include "MPU-6050.h"
#include "nextion.h"
/* USER CODE END Includes */

/* USER CODE BEGIN PTD */
void Data_Parsing(void);
void Data_Convert(void);
void Data_ToNextion(void);
double deg2rad(float deg);
float Cal_distGPS(float lat, float lng, float ground_latt, float ground_lngg);
void finding_maxmin(void);
double rad2deg(float rad);
float GetAngle(float lat, float lng, float ground_latt, float ground_lngg);
float calcoor(float x);

char RX1_BUF[100] = {0};
char LAT[9] = {0};
char LONG[10] = {0};
char COOR[25] = {0};
char TIME[10] = {0};

float ground_lat = .0;
float ground_lng = .0;
int time = 0;

extern uint8_t c1;
extern uint8_t gps_size;


#define cal_num 150
float compass_val = .0;
float X = .0, Y = .0, Z = .0;
extern float ground_lat;
extern float ground_lng;
float EPH_lat = .0;
float EPH_lng = .0;
float PL_lat = .0;
float PL_lng = .0;

float R = 6378.1; // Radius of the earth in km
float dLat = .0; // deg2rad below
float dLon = .0;
float a = .0;
float c = .0;
float d = .0; // Distance in km
float distance = .0;
float EPH_distance = .0;
float PL_distance = .0;
float EPH_Angle = .0;
float PL_Angle = .0;

uint8_t mgn = 0;
uint8_t recal = 0;
uint8_t stop = 0;
uint8_t newrecord = 0;
uint8_t pause = 0;
uint8_t cont = 0;

extern uint8_t gps;

char ID = '\0';
char sn[2] = {0};
char lat1[10] = {0};
char lng1[10] = {0};
char alt[7] = {0};
char vlc[6] = {0};
char rollpitch[13] = {0};
char apg[1] = {0};
char mn[1] = {0};
uint8_t fall = 0;
uint8_t cal_dis = 0;
uint8_t GS_LC = 0;

extern uint32_t SystemCoreClock;
uint32_t Systemlock = 0;

float vlcf = .0, altf = .0;
int alti = 0, vlci = 0, EPHmax_alti = 0, EPHmax_vlci = 0 , EPHmin_vlci = 0, PLmax_alti = 0, PLmax_vlci = 0 , PLmin_vlci = 0;
int EPHalti = 0, EPHvlci = 0, PLalti = 0, PLvlci = 0, PLmin_alti = 1000, EPHmin_alti = 1000;
// PLmin_alti  EPHmin_alti

int16_t speedometer = 0;
/* USER CODE END PTD */

/* USER CODE BEGIN PD */
char RX2_BUF[80] = {0};
char NEXT_BUFF[100] = { 0 };
uint8_t RX2 = 0;

uint8_t ADDH = 0x6;
uint8_t ADDL = 0x4A;
uint8_t CHN = 0xA;
uint8_t MODE = 1;

int16_t Xg = 0, Yg = 0, Zg = 0;

void LORA_READ_PARAMETER(void);
void LORA_CONFG(uint8_t ADDH, uint8_t ADDL, uint8_t CHN, uint8_t MODE);
/* USER CODE END PD */

I2C_HandleTypeDef hi2c1;

TIM_HandleTypeDef htim2;

UART_HandleTypeDef huart1;
UART_HandleTypeDef huart2;
UART_HandleTypeDef huart3;

void SystemClock_Config(void);
static void MX_GPIO_Init(void);
static void MX_I2C1_Init(void);
static void MX_USART1_UART_Init(void);
static void MX_USART2_UART_Init(void);
static void MX_USART3_UART_Init(void);
static void MX_TIM2_Init(void);
/**
  * @brief  The application entry point.
  * @retval int
  */
int main(void)
{
  /* MCU Configuration--------------------------------------------------------*/

  /* Reset of all peripherals, Initializes the Flash interface and the Systick. */
  HAL_Init();

  /* Configure the system clock */
  SystemClock_Config();

  /* Initialize all configured peripherals */
  MX_GPIO_Init();
  MX_I2C1_Init();
  MX_USART1_UART_Init();
  MX_USART2_UART_Init();
  MX_USART3_UART_Init();
  MX_TIM2_Init();
  /* USER CODE BEGIN 2 */
  //I2C_SCAN();
	LORA_READ_PARAMETER();
	LORA_CONFG(ADDH, ADDL, CHN, MODE); // HIGH ADDRESS, LOW ADDRESS, CHANNEL, MODE (0 : TRANSPARENT, 1 : FIXED)
	MPU6050_Init();
	for (uint8_t i = 0; i < 8; i++) {
		HAL_GPIO_TogglePin(GPIOB, GPIO_PIN_4);
		HAL_Delay(50);
	}
	magneto_Init(cal_num);
	__HAL_UART_ENABLE_IT(&huart3, UART_IT_RXNE);
	HAL_TIM_Base_Start_IT(&htim2);
	__HAL_UART_ENABLE_IT(&huart2, UART_IT_RXNE);
	__HAL_UART_ENABLE_IT(&huart1, UART_IT_RXNE);

  /* USER CODE END 2 */

  /* Infinite loop */
  /* USER CODE BEGIN WHILE */
  while (1)
  {
    /* USER CODE END WHILE */

    /* USER CODE BEGIN 3 */
		if (mgn == 1) {
			compass_val = Read_compass();
			NXT_SEND_VALFLOAT("page2.t7.txt", compass_val);
			NXT_SEND_VAL("page2.z0.val", (uint32_t) compass_val);
			compass_val -= 90;
			if (compass_val < 0)
				compass_val += 360;
			NXT_SEND_TXT("page2.t7.txt", (uint16_t) compass_val);
			mgn = 0;
		}
		if (recal == 1) {
			//magneto_Init(cal_num);
			recal = 0;
		}
		if (RX2 == 1) {
			HAL_GPIO_WritePin(GPIOB, GPIO_PIN_4, SET);
			RX2 = 0;
			uint8_t m = 0;
			uint8_t go = 0;
			for (uint8_t k = 0; k < sizeof(RX2_BUF); k++) {
				if (RX2_BUF[k] == ':' && go == 0) {
					go = 1;
				}
				if (go == 1) {
					NEXT_BUFF[m] = RX2_BUF[k - 1];
					m++;
				}
				if (go == 1 && RX2_BUF[k] == '\n')
					break;
			}
			//if(NEXT_BUFF[0] != '\0' || NEXT_BUFF[1] || '\0' || NEXT_BUFF[2] != '\0')
			NXT_SEND_TXTBX("page1.t12.txt", NEXT_BUFF);

			for (uint8_t i = 0; i < sizeof(RX2_BUF); i++)
				RX2_BUF[i] = '\0';
			Data_Parsing();
			HAL_GPIO_WritePin(GPIOB, GPIO_PIN_4, RESET);
		}
		if (cal_dis == 1) {
			if (ground_lat == .0 && ground_lng == .0) {
				NXT_SEND_TXTBX("page2.t4.txt", "veri yok");
				NXT_SEND_TXTBX("page2.t6.txt", "veri yok");
			} else if (EPH_lat == .0 && EPH_lng == .0) {
				NXT_SEND_TXTBX("page2.t4.txt", "veri yok");
			} else {
				EPH_distance = Cal_distGPS(EPH_lat, EPH_lng, ground_lat,
						ground_lng);
				EPH_Angle = GetAngle(EPH_lat, EPH_lng, ground_lat, ground_lng);
				NXT_SEND_VALFLOAT("page2.t4.txt", EPH_distance);
				NXT_SEND_VALFLOAT("page2.t3.txt", EPH_Angle);
				EPH_Angle += 90.0;
				if (EPH_Angle > 360) {
					EPH_Angle -= 360;
				}
				NXT_SEND_VAL("page2.z1.val", (uint32_t) EPH_Angle);
			}
			if ((PL_lat == .0 && PL_lng == .0) || GS_LC == 1) {
				NXT_SEND_TXTBX("page2.t6.txt", "veri yok");
			} else {
				PL_distance = Cal_distGPS(PL_lat, PL_lng, ground_lat,
						ground_lng);
				PL_Angle = GetAngle(PL_lat, PL_lng, ground_lat, ground_lng);
				NXT_SEND_VALFLOAT("page2.t6.txt", PL_distance);
				NXT_SEND_VALFLOAT("page2.t5.txt", PL_Angle);
				PL_Angle += 90.0;
				if (PL_Angle > 360) {
					PL_Angle -= 360;
				}
				NXT_SEND_VAL("page2.z2.val", (uint32_t) PL_Angle);
			}

			cal_dis = 0;
		}
		if (gps == 1) {
			for (uint8_t i = 0; i < gps_size; i++) {
				if (RX1_BUF[i] == '$' && RX1_BUF[i + 1] == 'G'
						&& RX1_BUF[i + 2] == 'P' && RX1_BUF[i + 3] == 'G'
						&& RX1_BUF[i + 4] == 'G' && RX1_BUF[i + 5] == 'A'
						&& RX1_BUF[i + 6] == ',') {
					uint8_t v = 0, pos1 = 0, pos2 = 0, pos3 = 0, pos4 = 0,
							pos5 = 0, ok1 = 0, ok2 = 0, ok3 = 0, ok4 = 0;
					for (uint8_t n = 0; n < sizeof(RX1_BUF); n++) {  //  ONEMLI
						if (RX1_BUF[n] == ',' && n > i + 5)
							v++;
					}
						if (v >= 5) { // new condition
							v = 0;
							for (uint8_t n = 0; n < sizeof(RX1_BUF); n++) { //  ONEMLI
								if (RX1_BUF[n] == ',' && n > i + 5)
									v++;
								if (v == 1 && ok1 == 0) {
									pos1 = n;
									ok1 = 1;
								}
								if (v == 2 && ok2 == 0) {
									pos2 = n;
									for (uint8_t count = 0; count < pos2 - pos1;
											count++)
										TIME[count] = RX1_BUF[pos1 + count + 1];
									ok2 = 1;
								}
								if (v == 3 && ok3 == 0) {
									pos3 = n;
									for (uint8_t count = 0; count < pos3 - pos2;
											count++)
										LAT[count] = RX1_BUF[pos2 + count + 1];
									ok3 = 1;
								}
								if (v == 4 && ok4 == 0) {
									pos4 = n;
									ok4 = 1;
								}
								if (v == 5) {
									pos5 = n;
									for (uint8_t count2 = 0;
											count2 < pos5 - pos4; count2++)
										LONG[count2] =
												RX1_BUF[pos4 + count2 + 1];

									strcpy(TIME, TIME);
									strcpy(LAT, LAT);
									strcpy(LONG, LONG);
									time = atof(TIME);
									ground_lat = calcoor(atof(LAT));
									ground_lng = calcoor(atof(LONG));
									if(ground_lat >= 10. && ground_lng >= 10.){
									sprintf(COOR, ":%2.7f:%2.7f\n", ground_lat,
											ground_lng);
									/*HAL_UART_Transmit(&huart3, (uint8_t*) COOR,
									 sizeof(COOR), 1000);*/
									uint32_t lat0next = 0;
									uint32_t lng0next = 0;
									lat0next = (uint32_t) (ground_lat
											* 10000000.0);
									lng0next = (uint32_t) (ground_lng
											* 10000000.0);
									NXT_SEND_VAL("page1.x8.val", lat0next);
									NXT_SEND_VAL("page1.x9.val", lng0next);
									cal_dis = 1;
									}
									for (uint8_t c = 0; c < sizeof(RX1_BUF);
											c++)
										RX1_BUF[c] = '\0';
									break;
								}
							}
							break;
						}
					}
				}
				gps_size = 0;
				gps = 0;
			}
  }
  /* USER CODE END 3 */
}

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
/* USER CODE BEGIN 4 */
void LORA_CONFG(uint8_t ADDH, uint8_t ADDL, uint8_t CHN, uint8_t MODE)
{
	HAL_GPIO_WritePin(GPIOA, GPIO_PIN_0, SET);
	HAL_GPIO_WritePin(GPIOA, GPIO_PIN_1, SET);
	HAL_Delay(50);

	char cfg_buff[6] = {0};
	enum lora{Transparent, Fixed} mode;
	mode = MODE;

	cfg_buff[0] = 0xC0;  // header for saving paramater when power down C0
	cfg_buff[1] = ADDH;  // high address
	cfg_buff[2] = ADDL;  // low address
	cfg_buff[3] = 0x19;  // SPED (parity, baud, data rate)
	cfg_buff[4] = CHN;   // channel

	switch(mode){
	case Transparent:
		cfg_buff[5] = 0x44;  // option
		break;
	case Fixed:
		cfg_buff[5] = 0xC4;  // option
		break;
	default:
		cfg_buff[5] = 0x44;  // option
	}

	HAL_UART_Transmit(&huart2, (uint8_t*) cfg_buff, 6, 1000);

	HAL_Delay(25);
	HAL_GPIO_WritePin(GPIOA, GPIO_PIN_0, RESET);
	HAL_GPIO_WritePin(GPIOA, GPIO_PIN_1, RESET);
	HAL_Delay(25);
}

void LORA_READ_PARAMETER()
{
	HAL_GPIO_WritePin(GPIOA, GPIO_PIN_0, SET);
	HAL_GPIO_WritePin(GPIOA, GPIO_PIN_1, SET);
	HAL_Delay(50);

	char buff_read[6] = {0};
	buff_read[0] = 0xC1;
	buff_read[1] = 0xC1;
	buff_read[2] = 0xC1;

	HAL_UART_Transmit(&huart2, (uint8_t*) buff_read, 3, 1000);
	HAL_UART_Receive(&huart2, (uint8_t*) buff_read, 6, 1000);

	HAL_Delay(25);
	HAL_GPIO_WritePin(GPIOA, GPIO_PIN_0, RESET);
	HAL_GPIO_WritePin(GPIOA, GPIO_PIN_1, RESET);
	HAL_Delay(25);
}

void Data_Parsing(void) {
	uint8_t first = 0, second = 0, countstr = 0;
	for (uint8_t i = 0; i < sizeof(NEXT_BUFF); i++) {
		if (NEXT_BUFF[i] == ':') {
			first = second;
			second = i;
			countstr++;
			uint8_t countstr1 = 0;
			for (first++; first < second; first++) {
				switch (countstr) {
				case 2:
					sn[countstr1] = NEXT_BUFF[first];
					countstr1++;
					break;
				case 3:
					lat1[countstr1] = NEXT_BUFF[first];
					countstr1++;
					break;
				case 4:
					lng1[countstr1] = NEXT_BUFF[first];
					countstr1++;
					break;
				case 5:
					alt[countstr1] = NEXT_BUFF[first];
					countstr1++;
					break;
				case 6:
					vlc[countstr1] = NEXT_BUFF[first];
					countstr1++;
					break;
				case 7:
					rollpitch[countstr1] = NEXT_BUFF[first];
					countstr1++;
					break;
				case 8:
					apg[countstr1] = NEXT_BUFF[first];
					countstr1++;
					break;
				case 9:
					mn[countstr1] = NEXT_BUFF[first];
					countstr1++;
					break;
				}
			}
		}
	}

	ID = NEXT_BUFF[0];

	Data_Convert();
	for (uint8_t i = 0; i < sizeof(NEXT_BUFF); i++)
		NEXT_BUFF[i] = '\0';
}

void Data_Convert(void) {
	finding_maxmin();

	if (ID == '0') {
		strcpy(lat1, lat1);
		strcpy(lng1, lng1);
		EPH_lat = atof(lat1);
		EPH_lng = atof(lng1);
	} else if (ID == '1') {
		strcpy(lat1, lat1);
		strcpy(lng1, lng1);
		PL_lat = atof(lat1);
		PL_lng = atof(lng1);
	}

	if(vlcf < 0){
		vlcf *= -1;
		fall = 1;
	}else fall = 0;

	speedometer = 336 + (int16_t)((vlcf / 300.0) * 225);
	if(speedometer > 360) speedometer -= 360;

	Data_ToNextion();
}

void Data_ToNextion(void) {

	if (EPH_lat != .0 && EPH_lng != .0) {	// EPHEMERISH son enlem, boylam verileri
		NXT_SEND_TXTBX("page3.t34.txt", lat1);
		NXT_SEND_TXTBX("page3.t35.txt", lng1);
	}
	if (PL_lat != .0 && PL_lng != .0) {		// PAYLOAD son enlem, boylam verileri
		NXT_SEND_TXTBX("page3.t36.txt", lat1);
		NXT_SEND_TXTBX("page3.t37.txt", lng1);
	}

	if (ID == '1') {
		NXT_SEND_TXTBX("page1.t14.txt", lat1);
		NXT_SEND_TXTBX("page1.t15.txt", lng1);
		NXT_SEND_TXTBX("page1.t16.txt", alt);

		NXT_SEND_SVAL("page3.x6.val", PLmax_vlci);
		NXT_SEND_SVAL("page3.x7.val", PLmin_vlci);
		NXT_SEND_SVAL("page3.x5.val", PLmax_alti);
		NXT_SEND_SVAL("page3.x11.val", PLmin_alti);

		NXT_SEND_SVAL("page1.c1.val", 1);
		NXT_SEND_SVAL("page1.c0.val", 0);
		NXT_SEND_SVAL("page1.z3.val", speedometer);
		if (fall == 1) {
			NXT_SEND_SVAL("page1.z3.pco", 31);
		} else {
			NXT_SEND_SVAL("page1.z3.pco", 63488);
		}

		NXT_SEND_SVAL("page1.x1.val", vlci);

	} else if (ID == '0') {
		NXT_SEND_TXTBX("page1.t8.txt", lat1);
		NXT_SEND_TXTBX("page1.t9.txt", lng1);
		NXT_SEND_TXTBX("page1.t13.txt", alt);

		NXT_SEND_SVAL("page3.x3.val", EPHmax_vlci);
		NXT_SEND_SVAL("page3.x4.val", EPHmin_vlci);
		NXT_SEND_SVAL("page3.x2.val", EPHmax_alti);
		NXT_SEND_SVAL("page3.x10.val", EPHmin_alti);  // PLmin_alti  EPHmin_alti

		NXT_SEND_SVAL("page1.c1.val", 0);
		NXT_SEND_SVAL("page1.c0.val", 1);
		NXT_SEND_SVAL("page1.z4.val", speedometer);
		if (fall == 1) {
			NXT_SEND_SVAL("page1.z4.pco", 31);
		} else {
			NXT_SEND_SVAL("page1.z4.pco", 63488);
		}

		NXT_SEND_SVAL("page1.x0.val", vlci);

		if (*apg == '1') {
			NXT_SEND_SVAL("page1.t10.bco", 63488);
		}
		if (*mn == '1') {
			NXT_SEND_SVAL("page1.t11.bco", 63488);
		}

	}

	ID = '\0';

}

void finding_maxmin(void) {
	strcpy(vlc, vlc);
	vlcf = atof(vlc);
	vlci = (int) (vlcf * 100.0);
	strcpy(alt, alt);
	altf = atof(alt);
	alti = (int) (altf * 100.0);
	if (ID == '0') {
		if (vlci > EPHmax_vlci)
			EPHmax_vlci = vlci;
		if (vlci < EPHmin_vlci)
			EPHmin_vlci = vlci;
		if (alti > EPHmax_alti)
			EPHmax_alti = alti;
		if (alti < EPHmin_alti)
			EPHmin_alti = alti;
	}
	else if (ID == '1') {
		if (vlci > PLmax_vlci)
			PLmax_vlci = vlci;
		if (vlci < PLmin_vlci)
			PLmin_vlci = vlci;
		if (alti > PLmax_alti)
			PLmax_alti = alti;
		if (alti < PLmin_alti)
			PLmin_alti = alti;
	}
}

double deg2rad(float deg) {
	double pi = 2 * acos(0.0);
	return deg * (pi / 180);
}

double rad2deg(float rad)
{
    double pi = 2 * acos(0.0);
    return (rad * 180 / pi);
}

float Cal_distGPS(float lat, float lng, float ground_latt, float ground_lngg) {
	dLat = deg2rad(lat - ground_latt); // deg2rad below
	dLon = deg2rad(lng - ground_lngg);
	a = sin(dLat / 2) * sin(dLat / 2)
			+ cos(deg2rad(lat)) * cos(deg2rad(ground_latt)) * sin(dLon / 2)
					* sin(dLon / 2);
	c = 2 * atan2(sqrt(a), sqrt(1 - a));
	d = R * c; // Distance in km
	distance = d * 1000;
	return distance;
}

float GetAngle(float lat, float lng, float ground_latt, float ground_lngg) {
	float Org_Enlem = lat;
	float Org_Lng = ground_lngg;

	float distance1 = Cal_distGPS(Org_Enlem, Org_Lng, lat, lng);
	float distance2 = Cal_distGPS(ground_latt, ground_lngg, Org_Enlem, Org_Lng);

	float alfa = rad2deg(atan2(distance1, distance2));
	if (lat == ground_latt && lng == ground_lngg) {
		alfa = 0;
	} else if (lat == ground_latt && lng > ground_lngg) {
		alfa = 0;
	} else if (lat == ground_latt && lng < ground_lngg) {
		alfa = 180;
	} else if (lat > ground_latt && lng == ground_lngg) {
		alfa = 90;
	} else if (lat > ground_latt && lng == ground_lngg) {
		alfa = 270;
	} else if (lat > ground_latt && lng > ground_lngg) {
		//cout << "degree: " << alfa << endl;
	} else if (lat < ground_latt && lng > ground_lngg) {
		alfa = 180 - alfa;
	} else if (lat > ground_latt && lng < ground_lngg) {
		alfa = 360 - alfa;
	} else if (lat < ground_latt && lng < ground_lngg) {
		alfa = 180 + alfa;
	}

	alfa -= 90.0;

	if (alfa < 0)
		alfa += 360;
	return alfa;
}

float calcoor(float x)
{
	float a = (int)x / 100;
	float b = (x - (a * 100.0)) / 60.0;
	return a+b;
}

void I2C_SCAN(void){
	uint8_t k = 0;
	for(uint8_t i = 0 ; i < 255 ; i++){
		if(HAL_I2C_IsDeviceReady(&hi2c1, i, 1, 10) == HAL_OK){
			k++;
		}
	}
}
/* USER CODE END 4 */
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
