Brain-dll/MIDDLE-ALTITUDE-GROUND-STATION-EMBEDDED-/GROUND_STATION_MAIN_SOFTWARE/Core/Inc/main.h

#define M0_Pin GPIO_PIN_0
#define M0_GPIO_Port GPIOA
#define M1_Pin GPIO_PIN_1
#define M1_GPIO_Port GPIOA
#define LED2_Pin GPIO_PIN_7
#define LED2_GPIO_Port GPIOA
#define LED_Pin GPIO_PIN_0
#define LED_GPIO_Port GPIOB
#define BUZZER_Pin GPIO_PIN_4
#define BUZZER_GPIO_Port GPIOB
