Brain-dll/MIDDLE-ALTITUDE-GROUND-STATION-EMBEDDED-/(commit log)

2021-04-03 Polygon witdh was increased IMPOTANT**
    [Mergen Ground Station_V2.0.brd, Mergen Ground Station_V2.0.sch]
2021-04-03 Polygon 15 mils
    [Mergen Ground Station_V2.0.brd]
2021-04-06 Terminal Blocks were changed
    [Mergen Ground Station_V2.0.brd, Mergen Ground Station_V2.0.sch]
2021-04-08 packages was modified according to stock situation
    [Mergen Ground Station_V2.0.brd, Mergen Ground Station_V2.0.sch]
2021-04-19 Some modification was done
    [Mergen Ground Station_V2.0.brd]
2021-05-03 Design was been modified by Osman, and component name locations was arranged
    [Mergen Ground Station_V2.0.brd, Mergen Ground Station_V2.0.sch]
2021-06-02 Ground station V2.0 released by brain.dll
    [Mergen Ground Station_V2.0.brd, Mergen Ground Station_V2.0.sch]
2021-06-14 Version 3.0 was relased by brain.dll
    [Mergen Ground Station_V2.0.brd, Mergen Ground Station_V2.0.sch]
2021-06-15 new buzzer was added
    [Mergen Ground Station_V2.0.brd, Mergen Ground Station_V2.0.sch]
2021-06-30 VDDA cap value was changed
    [Mergen Ground Station_V2.0.brd, Mergen Ground Station_V2.0.sch]
2021-07-05 Lora configuration connectors were added
    [Mergen Ground Station_V2.0.brd, Mergen Ground Station_V2.0.sch]
2021-09-17 Systems are stable
    [Mergen Ground Station_V2.0.brd, Mergen Ground Station_V2.0.sch]
