Brain-dll/MIDDLE-ALTITUDE-GROUND-STATION-EMBEDDED-/(notices)

Notices in the files:
GROUND_STATION_SOFTWARE/Core/Src/main.c:
© Copyright (c) 2021 STMicroelectronics.
All rights reserved.
This software component is licensed by ST under BSD 3-Clause license,
the "License"; You may not use this file except in compliance with the
License. You may obtain a copy of the License at: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
GROUND_STATION_SOFTWARE/Core/Inc/main.h:
(C) COPYRIGHT STMicroelectronics *****END OF FILE
parts and their libraries:
SparkFun-Batteries: Licensing: Creative Commons ShareAlike 4.0 International - https://creativecommons.org/licenses/by-sa/4.0
COPYRIGHT: Copyright (C) 2018 Accelerated Designs. All rights reserved
